daizeyao/fuzuki-offical/src/assets/products_img/CES-BES24.png

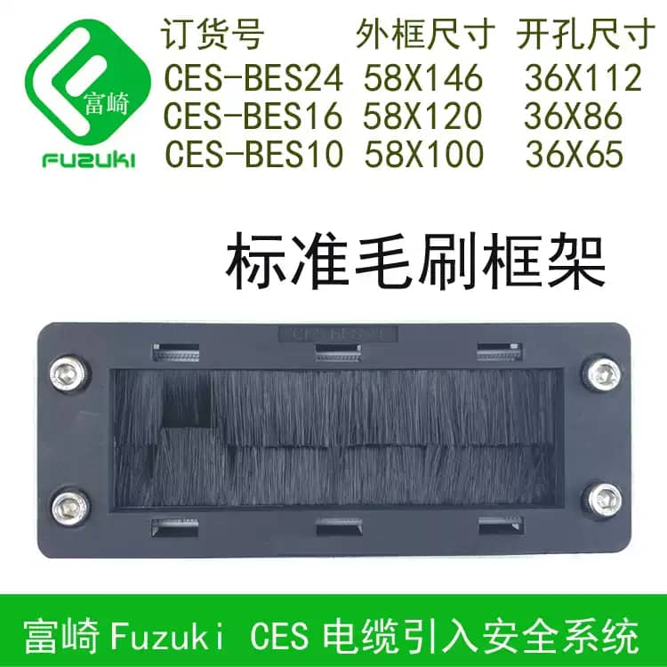
src/assets/products_img/CES-BES24.png
