daizeyao/fuzuki-offical/src/assets/products_img/MSDD08.png

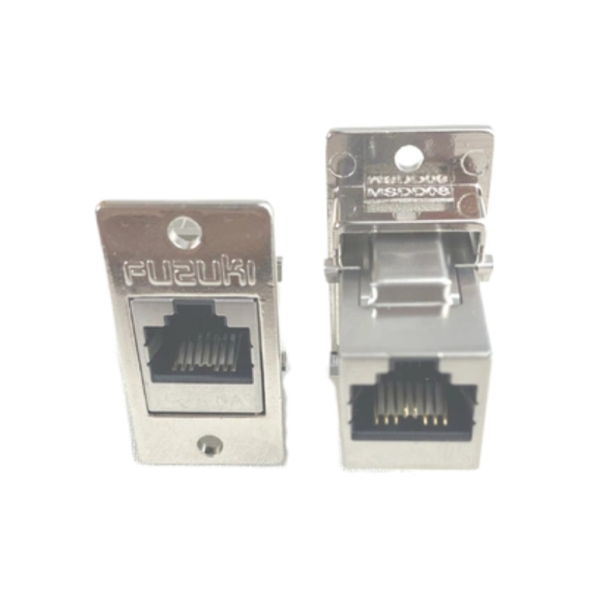
src/assets/products_img/MSDD08.png
