daizeyao/fuzuki-offical/src/assets/index_products/adapter.jpg

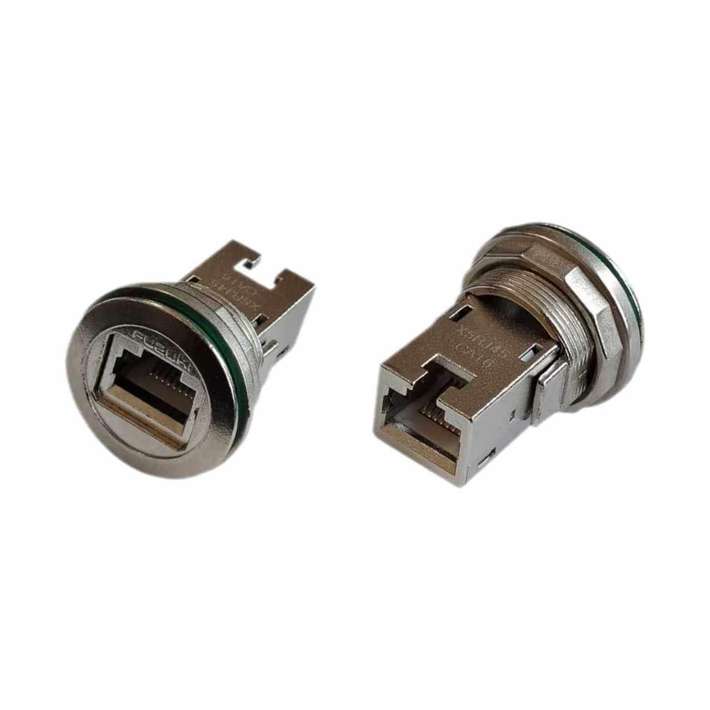
src/assets/index_products/adapter.jpg
