daizeyao/fuzuki-offical/src/assets/index_products/other.jpg

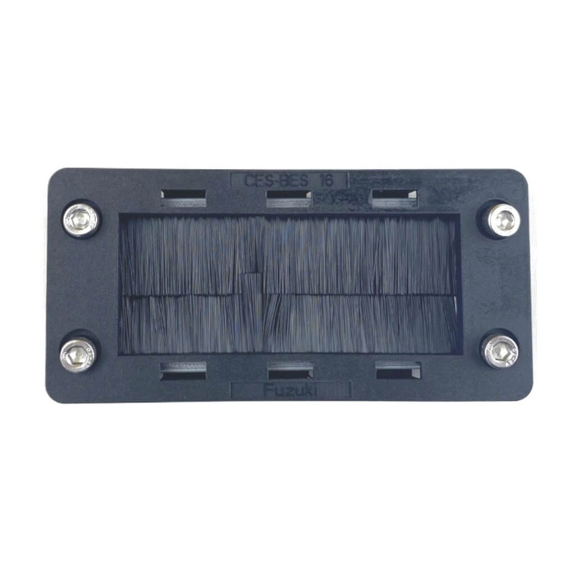
src/assets/index_products/other.jpg
