daizeyao/fuzuki-offical/src/assets/index_products/panel.png

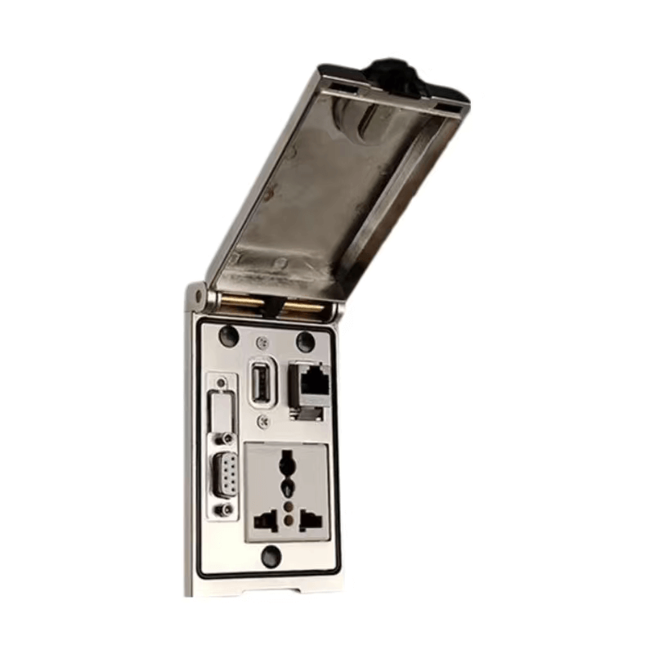
src/assets/index_products/panel.png
