daizeyao/fuzuki-offical/src/assets/index_products/wire.png

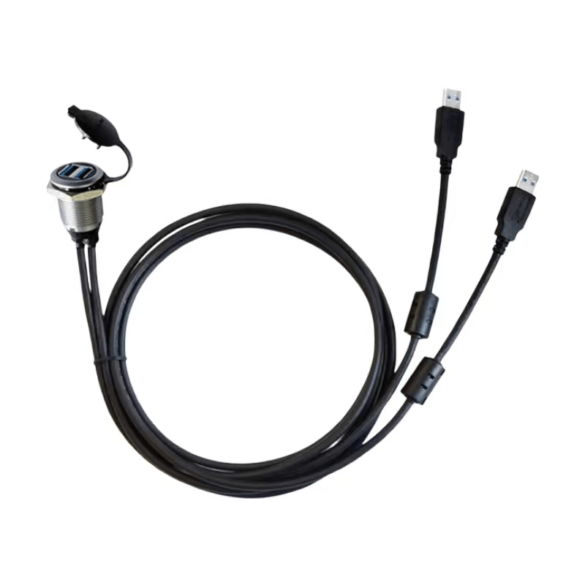
src/assets/index_products/wire.png
