daizeyao/fuzuki-offical/src/assets/products_img/A828.png

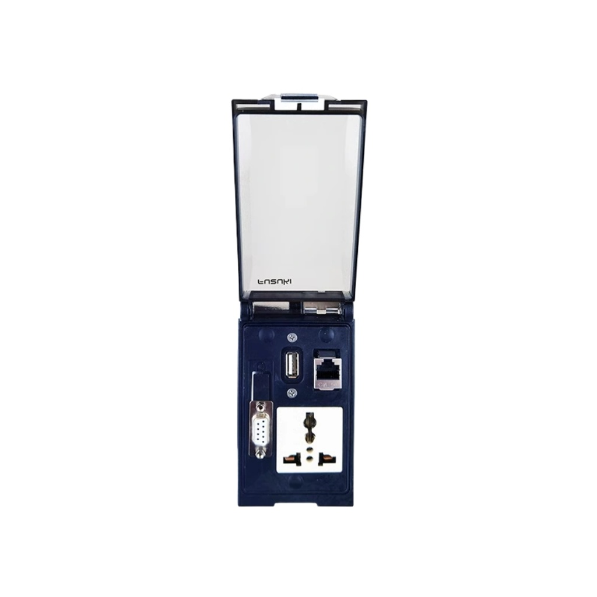
src/assets/products_img/A828.png
