daizeyao/fuzuki-offical/src/assets/products_img/MSDD90341.png

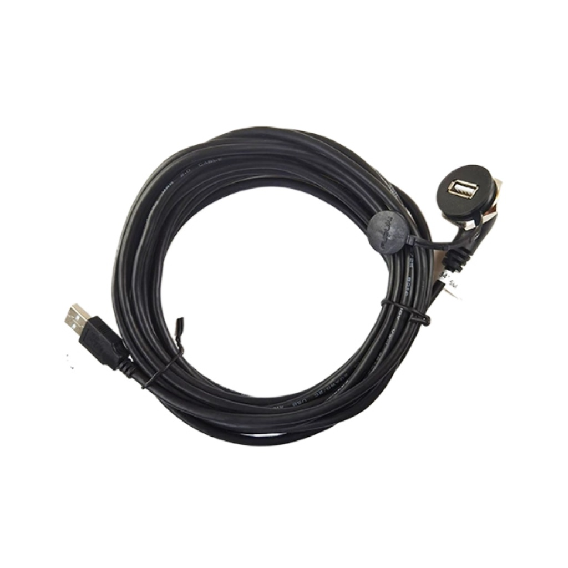
src/assets/products_img/MSDD90341.png
