daizeyao/fuzuki-offical/src/assets/products_img/MSDD90341F.png

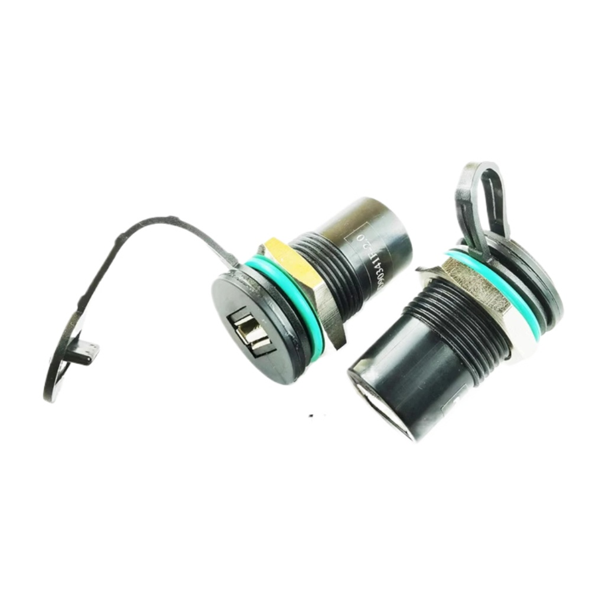
src/assets/products_img/MSDD90341F.png
