daizeyao/fuzuki-offical/src/assets/products_img/MSDD90401S.png

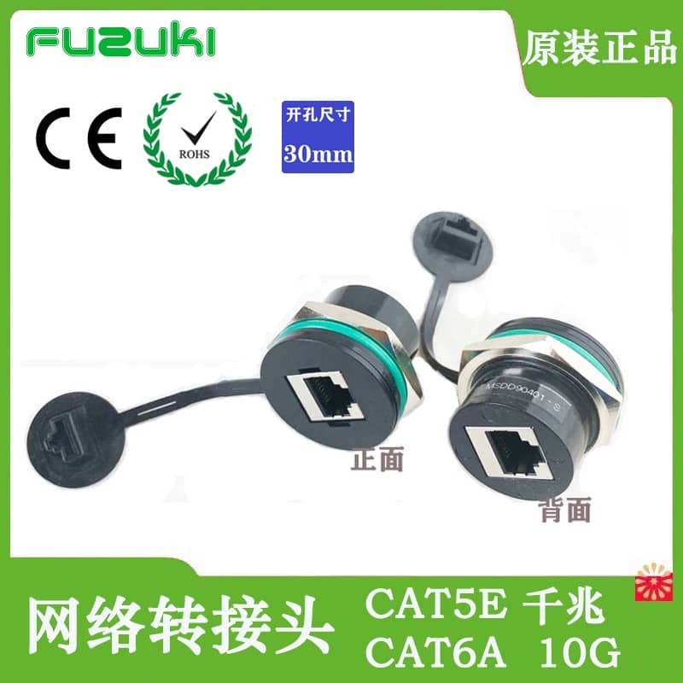
src/assets/products_img/MSDD90401S.png
