daizeyao/fuzuki-offical/src/assets/wechat.png

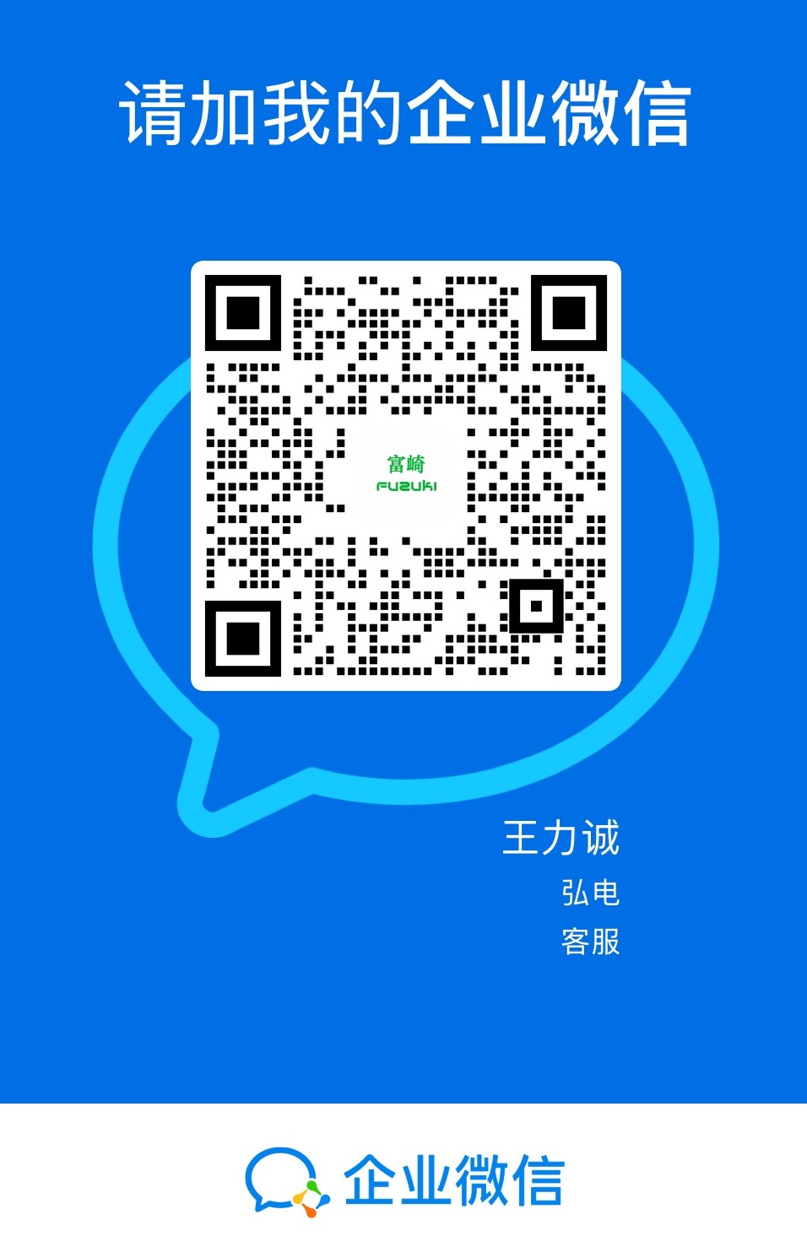
src/assets/wechat.png
