daizeyao/fuzuki-offical/src/assets/products/adapter/msdd90325/diagram/MSDD90325-TYPEC.stp

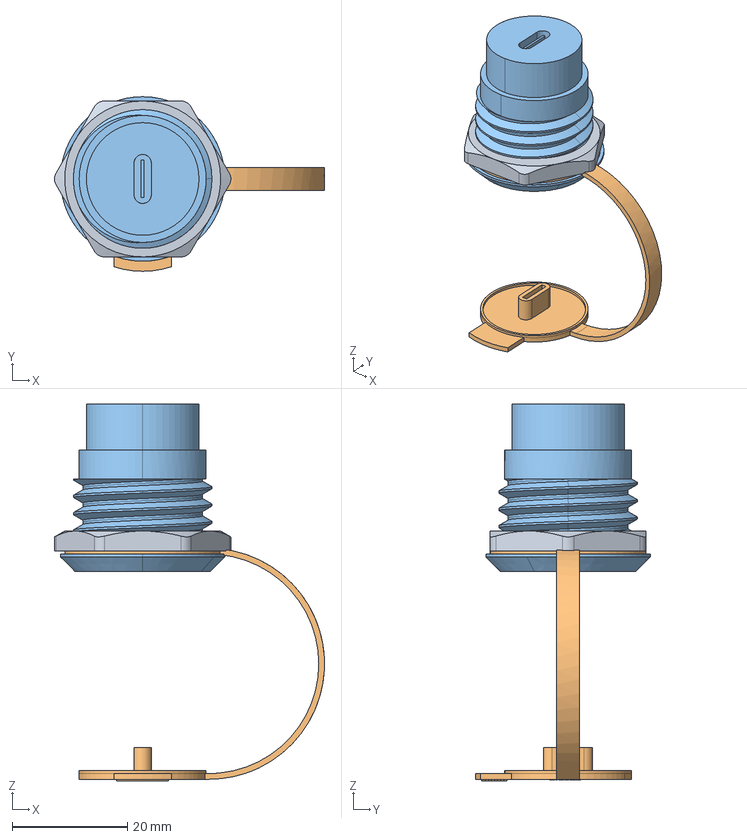
[picture p12: CAD file, 2025-04-12, last stored version]
src/assets/products/adapter/msdd90325/diagram/MSDD90325-TYPEC.stp
46.8 x 30.2 x 65.3 mm
