daizeyao/fuzuki-offical/src/assets/products/adapter/msdd90401M/diagram/PLUG金属防水插头.stp

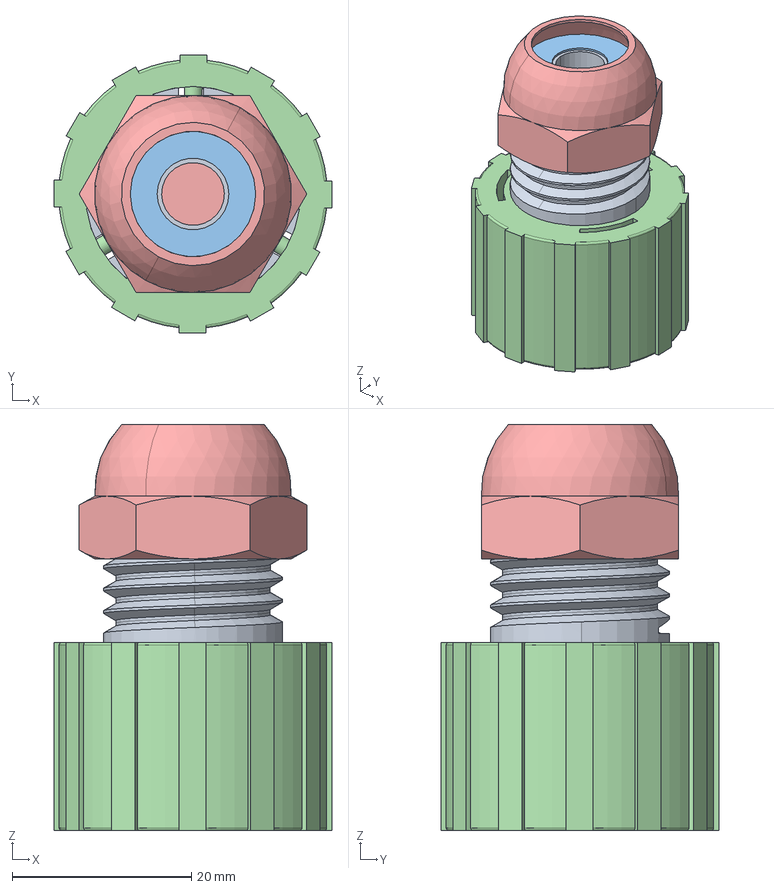
[picture p13: CAD file, 2025-04-12, last stored version]
src/assets/products/adapter/msdd90401M/diagram/PLUG金属防水插头.stp
31.0 x 31.0 x 45.3 mm
