daizeyao/fuzuki-offical/src/assets/products/adapter/msdd90401S/diagram/0MSDD90401S.STEP

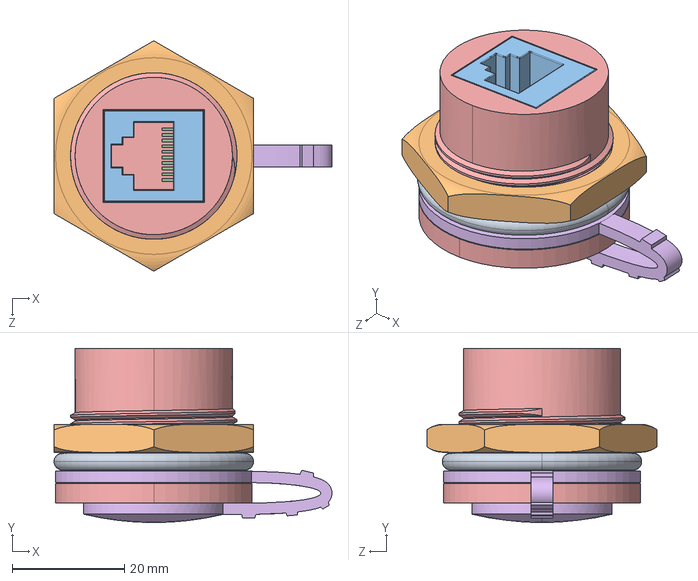
[picture p14: CAD file, 2025-04-12, last stored version]
src/assets/products/adapter/msdd90401S/diagram/0MSDD90401S.STEP
49.5 x 31.0 x 41.0 mm
