daizeyao/fuzuki-offical/src/assets/products/wire/BMSDD90618/diagram/BMSDD90618-0.5M.stp

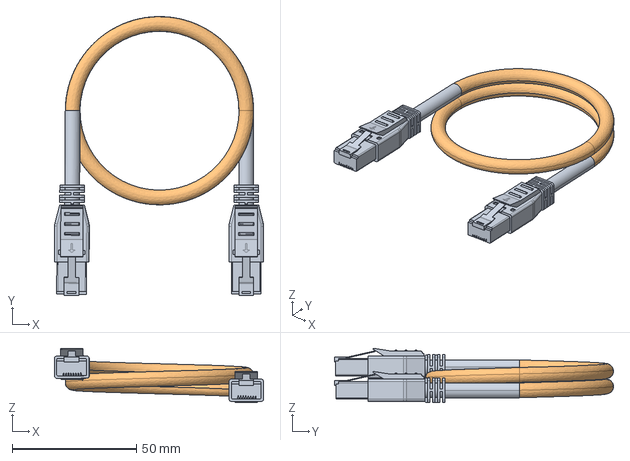
[picture p15: CAD file, 2025-04-12, last stored version]
src/assets/products/wire/BMSDD90618/diagram/BMSDD90618-0.5M.stp
84.4 x 112.5 x 21.9 mm
