daizeyao/fuzuki-offical/src/assets/products/wire/MSDD90341 带线/diagram/MSDD90350.stp

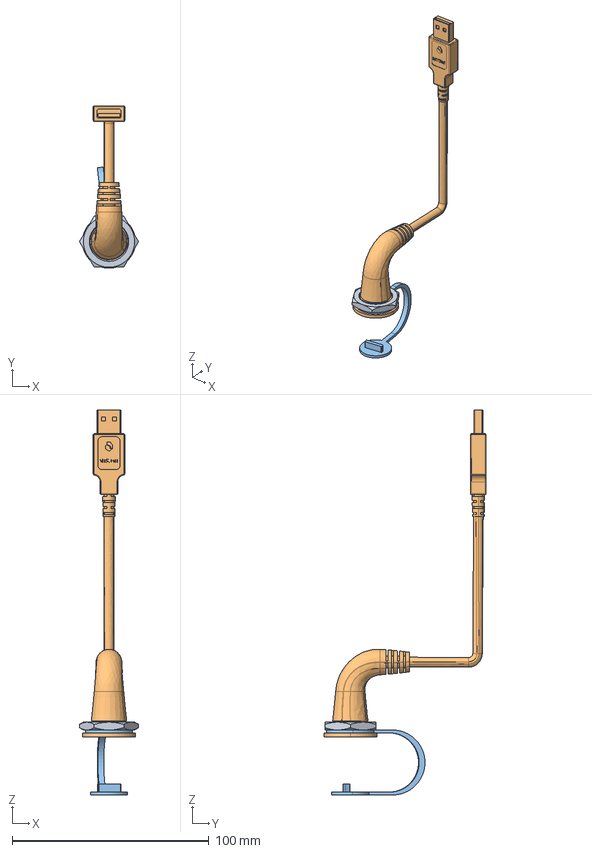
[picture p16: CAD file, 2025-04-12, last stored version]
src/assets/products/wire/MSDD90341 带线/diagram/MSDD90350.stp
30.0 x 82.5 x 195.5 mm
