daizeyao/fuzuki-offical/src/assets/products/wire/MSDD90705/diagram/MSDD90705-0.3m.stp

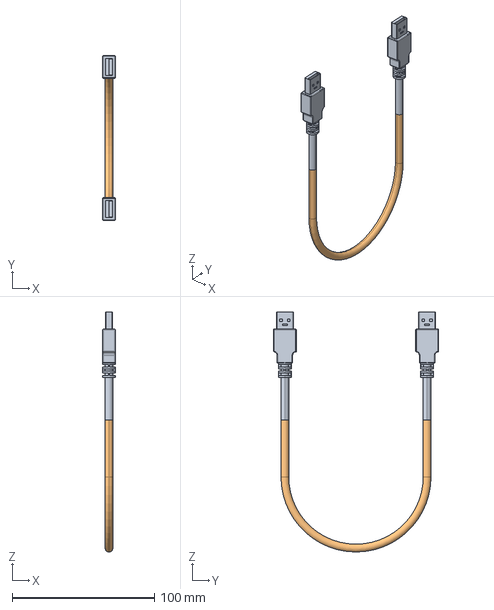
[picture p17: CAD file, 2025-04-12, last stored version]
src/assets/products/wire/MSDD90705/diagram/MSDD90705-0.3m.stp
9.00 x 116.0 x 168.8 mm
