daizeyao/fuzuki-offical/src/assets/products/panel/P型面板/diagram/P型组合插座.STEP

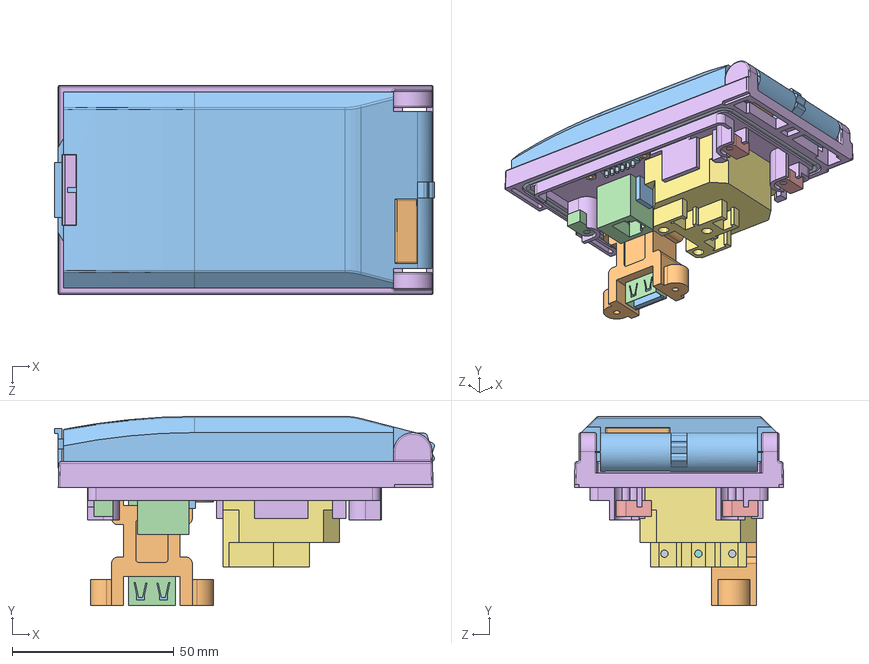
[picture p19: CAD file, 2025-04-12, last stored version]
src/assets/products/panel/P型面板/diagram/P型组合插座.STEP
117.6 x 58.5 x 64.8 mm
