daizeyao/fuzuki-offical/(list of files, cad)

Other CAD files:
src/assets/products/adapter/MSDD08/diagram/08/08-11 LC/08-11 LC.dwg
src/assets/products/adapter/MSDD08/diagram/08/08-12 TV/08-12 TV.dwg
src/assets/products/adapter/MSDD08/diagram/08/08-13 USB2.0（按照实际需要选择两种开孔尺寸）/MSDD08+USB2.0(一体化组合式样）/MSDD08+USB2.0（一体化组合式样）.dwg
src/assets/products/adapter/MSDD08/diagram/08/08-13 USB2.0（按照实际需要选择两种开孔尺寸）/MSDD08-USB2.0(客户自组装）/MSDD08-USB2.0（分体安装式）.dwg
src/assets/products/adapter/MSDD08/diagram/08/08-13 USB2.0（按照实际需要选择两种开孔尺寸）/MSDD08-USB2.0.dwg
src/assets/products/adapter/MSDD08/diagram/08/08-15(CAT5E,黑色塑料）/MSDD08-15(CAT5e黑色塑料）.dwg
src/assets/products/adapter/MSDD08/diagram/08/08-20 USB3.0 90°/08-20 USB3.0 90%d.dwg
src/assets/products/adapter/MSDD08/diagram/08/08-20 USB3.0 90°/08-90(USB3.0)/MSDD08-90(USB3.0).dwg
src/assets/products/adapter/MSDD08/diagram/08/08-21 CAT6/MSDD08-CAT6.dwg
src/assets/products/adapter/MSDD08/diagram/08/08-22 CAT5E-zcw/08-22 CAT5E-zcw.dwg
src/assets/products/adapter/MSDD08/diagram/08/08-25 SC/08-25 SC.dwg
src/assets/products/adapter/MSDD08/diagram/08/08-26 ST/08-26 ST.dwg
src/assets/products/adapter/MSDD08/diagram/08/08-27CAT6A-90°/08网口90度-CAT6A-90°/MSDD08-CAT6A-90°.dwg
src/assets/products/adapter/MSDD08/diagram/08/08-27CAT6A-90°/MSDD08-CAT6A-90°.dwg
src/assets/products/adapter/MSDD08/diagram/08/08-8 HDMI/08-8 HDMI.dwg
src/assets/products/adapter/MSDD08/diagram/08/08-CAT3/MSDD08-CAT3.dwg
src/assets/products/adapter/MSDD08/diagram/08/08-CAT6A(CAT7)-M/MSDD08-CAT6A-M.dwg
src/assets/products/adapter/MSDD08/diagram/08/08-CAT6A/MSDD08-CAT6A/MSDD08-CAT6A.dwg
src/assets/products/adapter/MSDD08/diagram/08/08-USB-AB/MSDD08-USB-AB/MSDD08-USB-AB.dwg
src/assets/products/other/CES-BES/diagram/新CES-BES 10.dwg
src/assets/products/panel/KJ118/diagram/KJ118全金属框架.dwg
src/assets/products/panel/M型面板/diagram/M1000.dwg
src/assets/products/panel/P型面板/diagram/新P11110组合插座.DWG
src/assets/products/adapter/MSDD08/diagram/08/08-CAT6A(CAT7)-M/新MSDD08-CAT6A(CAT7)-M.dwg
src/assets/products/panel/M型面板/diagram/新M1000.dwg
src/assets/products/wire/BMSDD90618/diagram/BMSDD90618-0.5M.dwg
src/assets/products/wire/MSDD90705/diagram/MSDD90705-0.3m.dwg
