daizeyao/fuzuki-offical/(commit log)

2025-04-05 feat: 第一版完成上线
2025-04-12 feat: 新增产品展示
    [08-11 LC.dwg, 08-12 TV.dwg, 08-20 USB3.0 90%d.dwg, 08-22 CAT5E-zcw.dwg, 08-25 SC.dwg, 08-26 ST.dwg, 08-8 HDMI.dwg, 0MSDD90401S.STEP]
2025-04-23 feat: 更新产品文件夹
    [08-11 LC.dwg, 08-12 TV.dwg, 08-20 USB3.0 90%d.dwg, 08-22 CAT5E-zcw.dwg, 08-25 SC.dwg, 08-26 ST.dwg, 08-8 HDMI.dwg, 0MSDD90401S.STEP]
2025-05-07 feat: 首页修改，物品页新增分页等
2025-05-12 feat: 修改首页栏&更新产品
2025-05-22 feat: 产品样式修改，更新product
2025-05-29 feat: 文案修改
2025-07-19 feat: 新增多语言
2025-08-16 feat: 更新店铺链接
2025-09-13 feat: 更新产品
2026-01-10 feat: 优化压缩处理逻辑
2026-01-11 feat: 260111版本上线
2026-01-18 feat: 更新图片
2026-02-07 feat: 文案
2026-04-12 feat: 首屏优化
